MoreThanRobotsFR/MTR_C3_TempHum/README.md

# MTR_C3_TempHum
A tiny temperature, humidity, gas, pressure, ambient light and presence detector (mmWave presence sensor) measurement unit for HomeAssistant using ESPHome
 
# In progress...
