MoreThanRobotsFR/MTR_C3_TempHum/Hardware/MTR_C3_TempHum/MTR_C3_TempHum.pdf

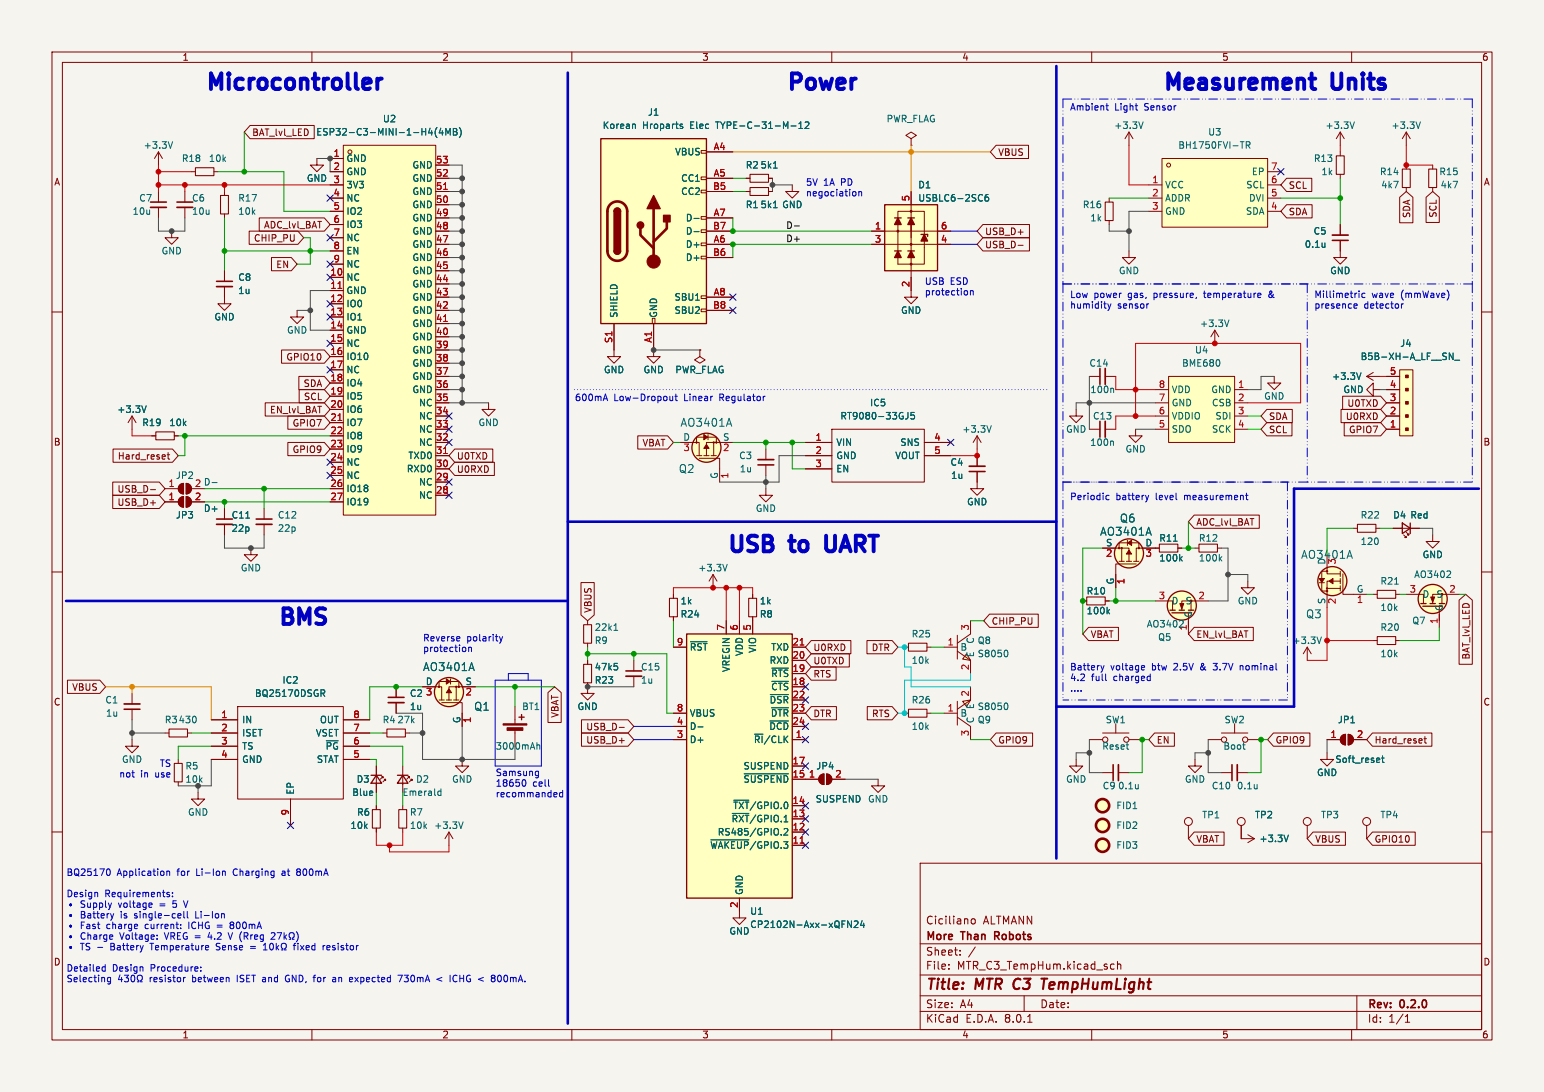
[picture p1: page 1]

U2 ESP32-C3-MINI-1-H4(4MB) GND 1 NC 10 GND 11
IO5 19 GND 2

3 Q8 S8050 GND 1 CSB 2 SDI 3 SCK 4 SDO 5 VDDIO 6 GND 7 VDD 8 U4 BME680 +3.3V GND GND

7 VBUS 8 ~{RST} 9 GND GND

7 VBUS 8 ~{RST} 9 U1 CP2102N-Axx-xQFN24 GND

2 RXD 20 TXD 21 ~{DSR} 22 ~{DTR} 23 ~{DCD} 24 D+ 3 D- 4 VIO

þÿ "Supply voltage = 5 V
þÿ "Charge Voltage: VREG = 4.2 V (Rreg þÿ27k©)
