MoreThanRobotsFR/MTR_C3_TempHum/Hardware/MTR_C3_TempHum/MTR_C3_TempHum.kicad_pcb

## KiCad design Hardware/MTR_C3_TempHum/MTR_C3_TempHum.kicad_pcb (2024-06-21)

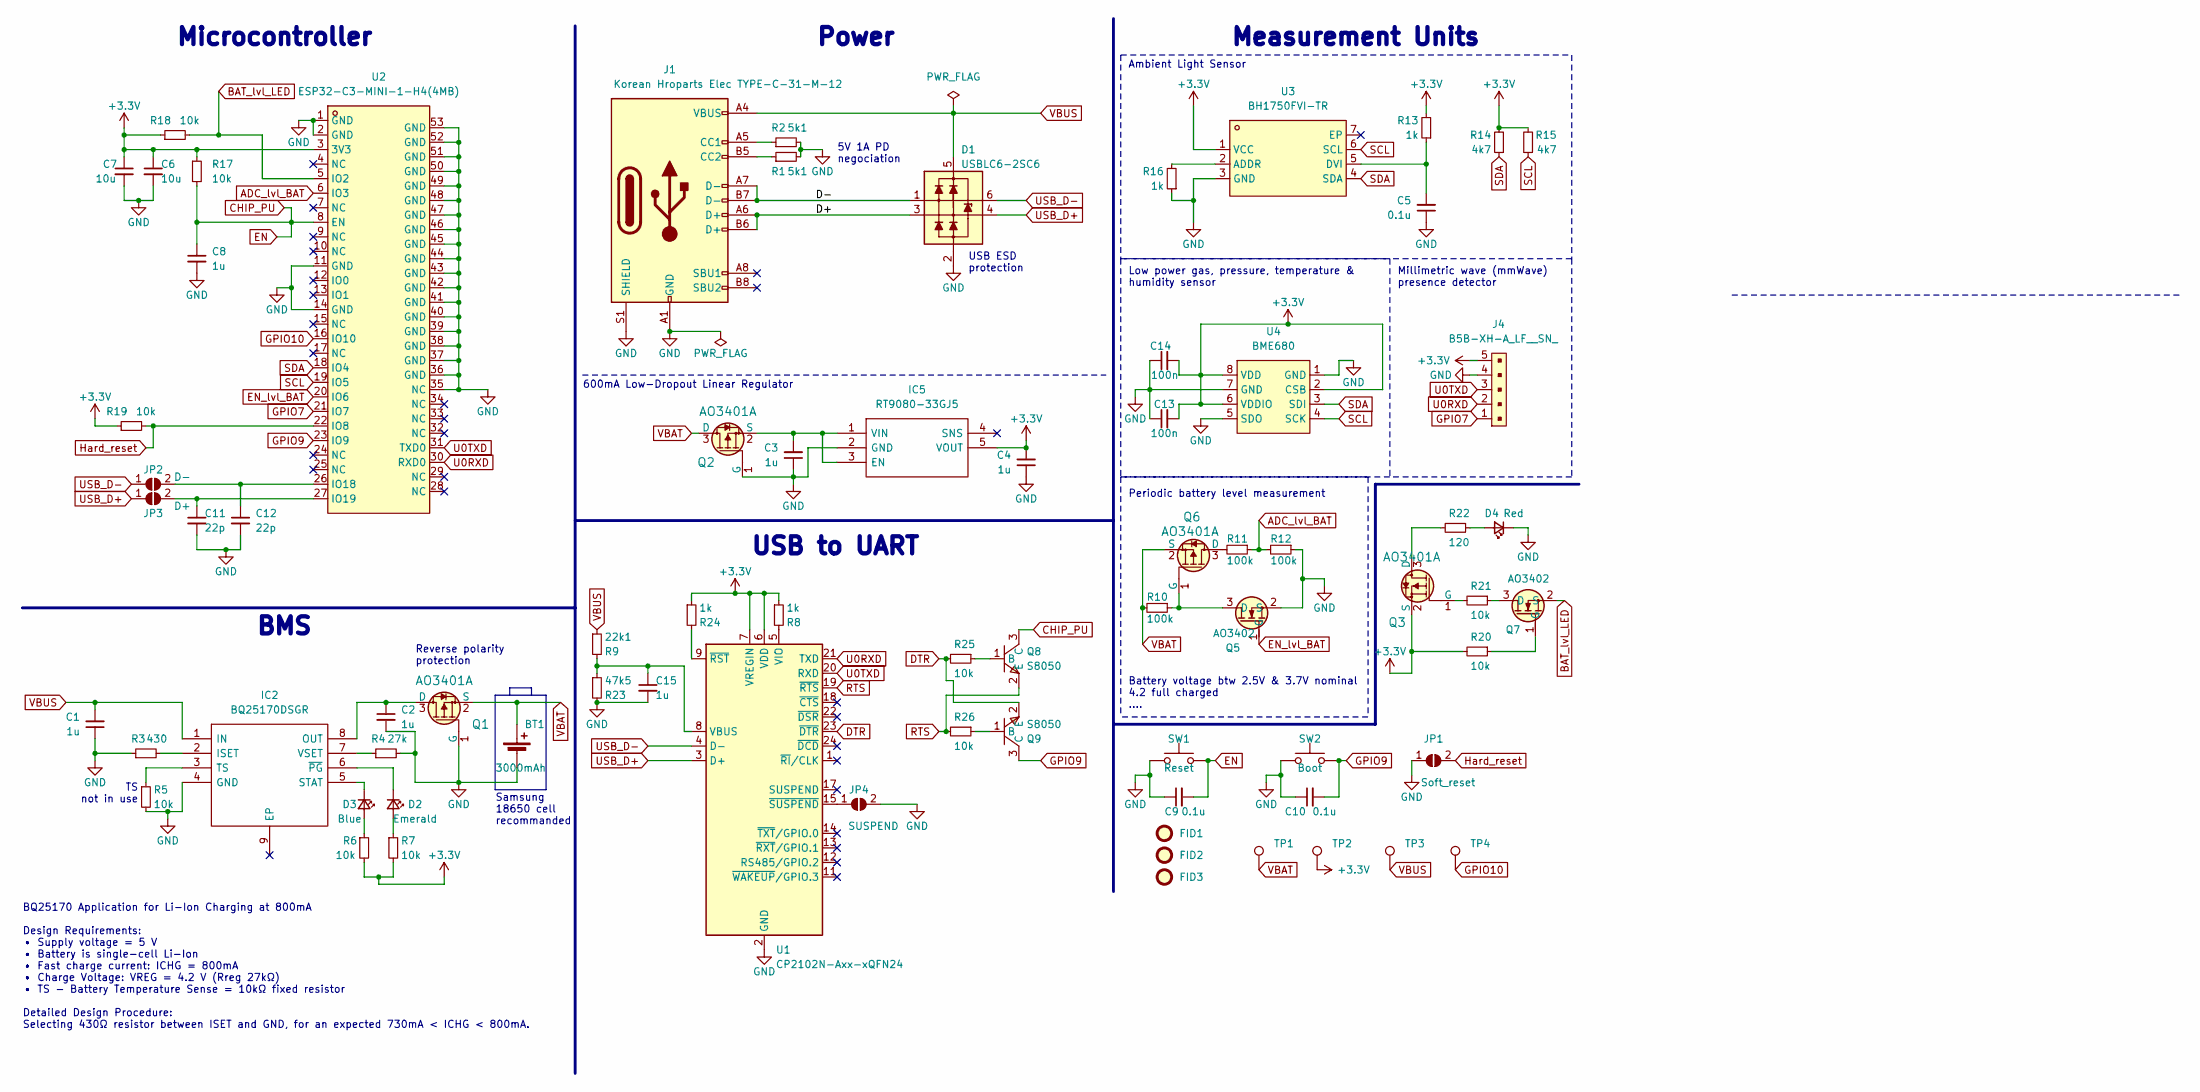
[picture p2: schematic MTR_C3_TempHum.kicad_sch, MTR C3 TempHumLight]

Parts:
BT1: 3000mAh; BATTERY-SMD_18650-1S-L77.1-W20.7-1; LCSC C2988620
C1, C2, C3, C4, C8, C15: 1u; R_0402_1005Metric; LCSC C14445
C5, C9, C10: 0.1u; R_0402_1005Metric; LCSC C60474
C6, C7: 10u; R_0402_1005Metric; LCSC C15525
C11, C12: 22p; R_0402_1005Metric; LCSC C14445
C13, C14: 100n; R_0402_1005Metric
D1: USBLC6-2SC6; SOT-23-6_L2.9-W1.6-P0.95-LS2.8-BL; LCSC C7519
D2: Emerald; LED_0603_1608Metric; LCSC C497927
D3: Blue; LED_0603_1608Metric; LCSC C5151484
D4: Red; LED_0603_1608Metric; LCSC C7371906
FID1, FID2, FID3: Fiducial; Fiducial_0.75mm_Mask2.25mm
IC2: BQ25170DSGR; WSON-8_L2.0-W2.0-P0.50-TL-EP; Manufacturer_Part_Number BQ25170DSGR; Mouser Part Number 595-BQ25170DSGR
IC5: RT9080-33GJ5; TSOT-23-5_L2.9-W1.6-P0.95-LS2.8-BL; Manufacturer_Part_Number RT9080-33GJ5; Mouser Part Number 835-RT9080-33GJ5
J1: Korean Hroparts Elec TYPE-C-31-M-12; USB_C_Receptacle_HRO_TYPE-C-31-M-12; LCSC C165948
J4: B5B-XH-A_LF__SN_; PinSocket_1x05_P1.27mm_Vertical; MPN B5B-XH-A(LF)(SN); Digi-Key_PN 455-2270-ND
JP1: Soft_reset; SolderJumper-2_P1.3mm_Open_RoundedPad1.0x1.5mm
JP2: D-; SolderJumper-2_P1.3mm_Open_TrianglePad1.0x1.5mm
JP3: D+; jumper perso1
JP4: SUSPEND; SolderJumper-2_P1.3mm_Open_TrianglePad1.0x1.5mm
Q1, Q2, Q3, Q6: AO3401A; SOT-23; MPN AO3401A; Digi-Key_PN 785-1001-1-ND
Q5, Q7: AO3402; SOT-23; LCSC C14385
Q8, Q9: S8050; SOT-23-3_L2.9-W1.3-P1.90-LS2.4-BR; LCSC Part C909746
R1, R2: 5k1; R_0402_1005Metric; LCSC C25905
R3: 430; R_0402_1005Metric; LCSC C163462
R4: 27k; R_0402_1005Metric; LCSC C138022
R5, R6, R7, R17, R18, R19, R20, R21, R25, R26: 10k; R_0402_1005Metric; LCSC C25744
R8, R13, R16, R24: 1k; R_0402_1005Metric; LCSC C11702
R9: 22k1; R_0402_1005Metric
R10, R11, R12: 100k; R_0402_1005Metric; LCSC C60491
R14, R15: 4k7; R_0402_1005Metric; LCSC C25900
R22: 120; R_0402_1005Metric; LCSC C25079
R23: 47k5; R_0402_1005Metric
SW1: Reset; SW-SMD_L4.0-W3.0-LS5.0; LCSC C2888420
SW2: Boot; SW-SMD_L4.0-W3.0-LS5.0; LCSC C2888420
TP1, TP2, TP3, TP4: TestPoint; TestPoint_Pad_D1.0mm
U1: CP2102N-Axx-xQFN24; QFN-24-1EP_4x4mm_P0.5mm_EP2.6x2.6mm; LCSC C969151
U2: ESP32-C3-MINI-1-H4(4MB); WIFIM-SMD_ESP32-C3-MINI-1; LCSC Part C2934569
U3: BH1750FVI-TR; WSOF-6_L2.6-W1.6-P0.50-TL-EP; LCSC Part C78960
U4: BME680; LGA-8_L3.0-W3.0-P0.80-TR; LCSC Part C125972

Connections:
+3.3V: C4.2, C6.1, C7.1, C13.2, C14.2, IC5.5 (VOUT), J4.5, Q3.2 (S), R6.2, R7.2, R8.1, R13.2, R14.2, R15.2, R17.1, R18.1, R19.1, R20.2, R24.1, TP2.1, U1.6 (VDD), U1.7 (VREGIN), U2.3 (3V3), U3.1 (VCC), U4.2 (CSB), U4.6 (VDDIO), U4.8 (VDD)
/D+: D1.3 (L2), J1.A6 (D+), J1.B6 (D+)
/D-: D1.1 (L1), J1.A7 (D-), J1.B7 (D-)
ADC_lvl_BAT: R11.1, R12.2, U2.6 (IO3)
BAT_lvl_LED: Q7.2 (S), R18.2, U2.5 (IO2)
CHIP_PU: C8.1, C9.2, Q8.3 (C), R17.2, SW1.2, U2.8 (EN)
DTR: Q9.2 (E), R25.2, U1.23 (~DTR)
EN_lvl_BAT: Q5.1 (G), U2.20 (IO6)
GND: BT1.2 (-), C1.1, C2.2, C3.1, C4.1, C5.1, C6.2, C7.2, C8.2, C9.1, C10.1, C11.2, C12.2, C13.1, C14.1, C15.2, D1.2 (VN), D4.1 (K), IC2.4 (GND), IC5.2 (GND), J1.A1 (GND), J1.A12 (GND), J1.B1 (GND), J1.B12 (GND), J1.S1 (SHIELD), J4.4, JP1.1 (A), JP4.2 (B), Q1.1 (G), Q2.1 (G), Q5.2 (S), R1.2, R2.2, R3.1, R4.2, R5.2, R12.1, R16.1, R23.2, SW1.1, SW2.1, U1.2 (GND), U1.25 (GND), U2.1 (GND), U2.2 (GND), U2.11 (GND), U2.14 (GND), U2.35 (NC), U2.36 (GND), U2.37 (GND), U2.38 (GND), U2.39 (GND), U2.40 (GND), U2.41 (GND), U2.42 (GND), U2.43 (GND), U2.44 (GND), U2.45 (GND), U2.46 (GND), U2.47 (GND), U2.48 (GND), U2.49 (GND), U2.50 (GND), U2.51 (GND), U2.52 (GND), U2.53 (GND), U3.3 (GND), U4.1 (GND), U4.5 (SDO), U4.7 (GND)
GPIO7: J4.1, U2.21 (IO7)
GPIO9: C10.2, Q9.3 (C), SW2.2, U2.23 (IO9)
GPIO10: TP4.1, U2.16 (IO10)
Hard_reset: JP1.2 (B), R19.2, U2.22 (IO8)
unnamed: D2.2 (A), R7.1
unnamed: D2.1 (K), IC2.6 (~PG)
unnamed: D3.2 (A), R6.1
unnamed: D3.1 (K), IC2.5 (STAT)
unnamed: D4.2 (A), R22.1
unnamed: IC2.2 (ISET), R3.2
unnamed: C2.1, IC2.8 (OUT), Q1.3 (D)
unnamed: IC2.3 (TS), R5.1
unnamed: IC2.7 (VSET), R4.1
unnamed: C3.2, IC5.1 (VIN), IC5.3 (EN), Q2.2 (S)
unnamed: J1.A5 (CC1), R2.1
unnamed: J1.B5 (CC2), R1.1
unnamed: C12.1, JP2.2 (B), U2.26 (IO18)
unnamed: C11.1, JP3.2 (B), U2.27 (IO19)
unnamed: JP4.1 (A), U1.15 (~SUSPEND)
unnamed: Q3.3 (D), R22.2
unnamed: Q3.1 (G), R21.2
unnamed: Q5.3 (D), Q6.1 (G), R10.1
unnamed: Q6.3 (D), R11.2
unnamed: Q7.3 (D), R21.1
unnamed: Q7.1 (G), R20.1
unnamed: Q8.1 (B), R25.1
unnamed: Q9.1 (B), R26.1
unnamed: C15.1, R9.2, R23.1, U1.8 (VBUS)
unnamed: R8.2, U1.5 (VIO)
unnamed: R24.2, U1.9 (~RST)
unnamed: R16.2, U3.2 (ADDR)
unnamed: C5.2, R13.1, U3.5 (DVI)
RTS: Q8.2 (E), R26.2, U1.19 (~RTS)
SCL: R15.1, U2.19 (IO5), U3.6 (SCL), U4.4 (SCK)
SDA: R14.1, U2.18 (IO4), U3.4 (SDA), U4.3 (SDI)
U0RXD: J4.2, U1.21 (TXD), U2.30 (RXD0)
U0TXD: J4.3, U1.20 (RXD), U2.31 (TXD0)
VBAT: BT1.1 (+), Q1.2 (S), Q2.3 (D), Q6.2 (S), R10.2, TP1.1
VBUS: C1.2, D1.5 (VP), IC2.1 (IN), J1.A4 (VBUS), J1.A9 (VBUS), J1.B4 (VBUS), J1.B9 (VBUS), R9.1, TP3.1

Notes on the sheet:
USB ESD protection
TS not in use
Periodic battery level measurement
Reverse polarity protection
BQ25170 Application for Li-Ion Charging at 800mA Design Requirements: • Supply voltage = 5 V • Battery is single-cell Li-Ion • Fast charge current: ICHG = 800mA • Charge Voltage: VREG = 4.2 V (Rreg 27kΩ) • TS - Battery Temperature Sense = 10kΩ fixed resistor Detailed Design Procedure: Selecting 430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
Power
Battery voltage btw 2.5V & 3.7V nominal 4.2 full charged ....
Millimetric wave (mmWave) presence detector
USB to UART
Low power gas, pressure, temperature & humidity sensor
BMS
Ambient Light Sensor
Measurement Units
5V 1A PD negociation
Samsung 18650 cell recommanded
600mA Low-Dropout Linear Regulator
Microcontroller

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
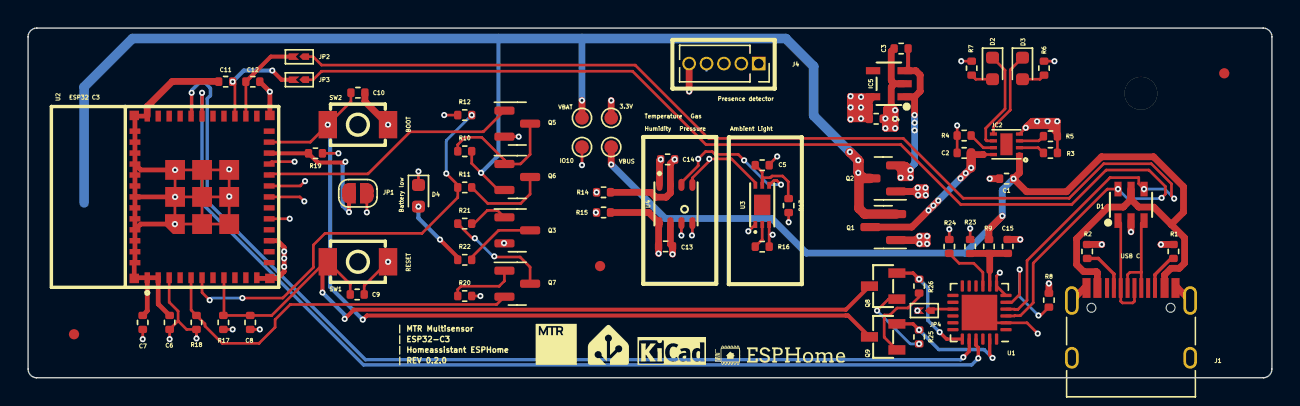
[picture p3: board MTR_C3_TempHum.kicad_pcb from above]

Board: 4 copper layers, 90.8 x 25.5 mm, 75 parts (1 on the bottom side), 50 nets.
