MoreThanRobotsFR/MTR_C3_TempHum/(commit log)

2024-02-13 REV 0.1
    [BOM-MTR_C3_TempHum.csv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]
2024-04-11 HTML BOM
